inruth/rova2026april/VisruthK_et_al_VisionAndEKFRover_2026.pdf

# Design and Implementation of a Vision Integrated

# Autonomous Research Rover

### Visruth K¹,∗ , Sevakumarr P R¹

### , Saran M S¹

### , V Sakthivel¹

### , Tamil Selvan M¹

1Department of Electronics and Communication Engineering,

Excel Engineering College, Namakkal, Tamil Nadu, India

∗Corresponding Author: visruthkelambeth@outlook.com.

ORCID: 0009-0006-0952-8436 (https://orcid.org/0009-0006-0952-8436)

Abstract

This paper presents the design and implementation of a low-cost, vision-integrated

autonomous rover for automated soil data collection. Traditional soil sampling

methods are labor-intensive, and existing robotic solutions frequently depend on

costly hardware and Global Positioning System (GPS) navigation, which can eas-

ily degrade in obstructed environments. To address these issues, a GPS-denied

rover was developed using a Raspberry Pi 4B for high-level computer vision and a

Robot Operating System 2 (ROS2) framework, paired with an Arduino Nano for

real-time hardware control. The platform utilizes a linear actuator to autonomously

deploy sensing probes for localized soil analysis. For stable navigation, an Extended

Kalman Filter (EKF) is implemented to fuse wheel encoder odometry with inertial

data. An OpenCV-based vision pipeline directs autonomous path following and

marker detection. To mitigate tracking errors caused by processing and mechan-

ical latency, a custom delay-compensation filter is introduced to actively reverse

the rover and correct overshoot. This is paired with a history-dependent sweep

prioritization algorithm that intelligently re-acquires lost paths based on prior trajectory data. The resulting system provides a reliable, accessible framework for

independent environmental monitoring.

Keywords: Autonomous rover, ROS2, computer vision, Extended Kalman Filter,

delay compensation, precision agriculture.

## 1 Introduction

Collecting accurate soil data is a fundamental requirement for environmental research

and localized field analysis. Manual soil sampling is notoriously slow and requires sig-

nificant human effort to cover large areas. While autonomous robots can automate this

process, commercial solutions are typically expensive and rely heavily on Global Posi-

tioning Systems (GPS) to navigate. This reliance on satellite data is a major limitation

in obstructed environments or smaller research plots where signals easily degrade.

There is a clear need for cost-effective data collection systems that can operate inde-

pendently of external positioning networks. This project addresses that gap by presenting

the design and implementation of a vision-integrated autonomous rover built entirely from

accessible, low-cost hardware. The system completely bypasses external GPS, relying in-

stead on onboard edge processing and visual markers to navigate and identify sampling

locations.

The architecture splits processing between two primary units. A Raspberry Pi 4B runs

the ROS2 Jazzy middleware to handle computer vision, node orchestration, and local

Wi-Fi communication. Simultaneously, an Arduino Nano executes real-time hardware

operations, acquiring sensor data and controlling the wheel locomotion via a high-power

BTS7960 motor driver.

The technical focus of this paper centers on achieving reliable state estimation and

navigation despite the inherent physical limitations of budget hardware. First, we outline

the implementation of an Extended Kalman Filter (EKF) that fuses basic wheel encoder

odometry with MPU6050 inertial data to maintain stable localization. Second, we detail

a lightweight OpenCV vision pipeline designed for path following and marker detection.

Because low-cost mechanical and processing components introduce latency that causes

the rover to overshoot its path, we developed a custom delay-compensation filter. This

filter actively reverses rover movement to self-correct tracking errors. Additionally, we

implemented a history-dependent sweep prioritization algorithm that uses past trajectory

data to intelligently re-acquire lost tracking lines.

The paper is structured as follows. Section 2 reviews related works. Section 3 details

the hardware layout and system architecture. Section 4 covers the kinematics and EKF

mathematical formulation. Section 5 explains the vision-based navigation logic, including

the delay-compensation filter and sweep prioritization. Section 6 presents field results

from the soil data acquisition, and Section 7 provides the conclusion.

## 2 Related Works

Recent advancements in autonomous agricultural robotics have heavily favored sensor-

rich platforms utilizing 3D LIDAR and Real-Time Kinematic (RTK) GPS for high-

precision navigation. For instance, comprehensive reviews of autonomous agricultural

vehicles demonstrate that while RTK-GPS can achieve sub-centimeter accuracy in open

fields, these systems suffer from significant signal degradation and multipath errors under

dense agricultural canopy cover [7].

To mitigate GPS dependency, researchers have increasingly explored monocular vi-

sual servoing and visual-inertial odometry (VIO) for row-following and crop tracking [8].

However, implementing robust visual navigation on resource-constrained edge computing

devices remains challenging due to high computational overhead and the unpredictable

slippage dynamics inherent to skid-steer kinematics on loose terrain [9]. Furthermore,

the inherent challenges of dead-reckoning on variable agricultural terrain underscore the

necessity of probabilistic state estimation. Foundational literature on mobile robotics

demonstrates that wheel slip introduces non-systematic errors that cannot be corrected

by pure mathematical odometry alone, mandating the use of sensor fusion models like

the Extended Kalman Filter to maintain localization [12], [13].

Recent modular implementations leveraging the ROS2 framework have shown promise

in managing hardware constraints through distributed processing architectures [10]. Un-

like these methods, which frequently rely on expensive depth cameras or heavy com-

putational payloads, our approach achieves reliable baseline navigation using low-cost

monocular vision paired with a novel active braking latency compensation strategy. This

makes the proposed architecture uniquely suited for budget-constrained, GPS-denied

agricultural applications.

## 3 System Architecture

The rover is engineered as a distributed, edge-computing platform designed to isolate

high-level decision-making from low-level real-time actuation. The system relies on a

local Wi-Fi communication layer established by the primary computing node, eliminating

the need for internet connectivity or external networking infrastructure.

### 3.1 High-Level Processing, Vision, and Soil Sensing

The primary computational node is a Raspberry Pi 4B, which serves as the central brain

of the rover. It executes the Robot Operating System 2 (ROS2 Jazzy) middleware,

processing high-bandwidth data from the visual sensors and computing the navigational

logic. A Raspberry Pi Camera Module V2 is connected via the Camera Serial Interface

(CSI) port for real-time image capture.

Unlike traditional setups where all sensors are routed through a microcontroller, the

Raspberry Pi directly handles the environmental data acquisition and actuator deploy-

ment loop. It interfaces directly with a waterproof DS18B20 temperature sensor probe

and an SP Electron soil moisture sensor. To physically collect soil data, a linear actu-

ator is integrated into the chassis. Power to this actuator is managed by a high-power

BTS7960 H-bridge motor driver, which receives its deployment commands directly from

the Raspberry Pi’s GPIO pins. The complete hardware power distribution architecture

is illustrated in Figure 1.

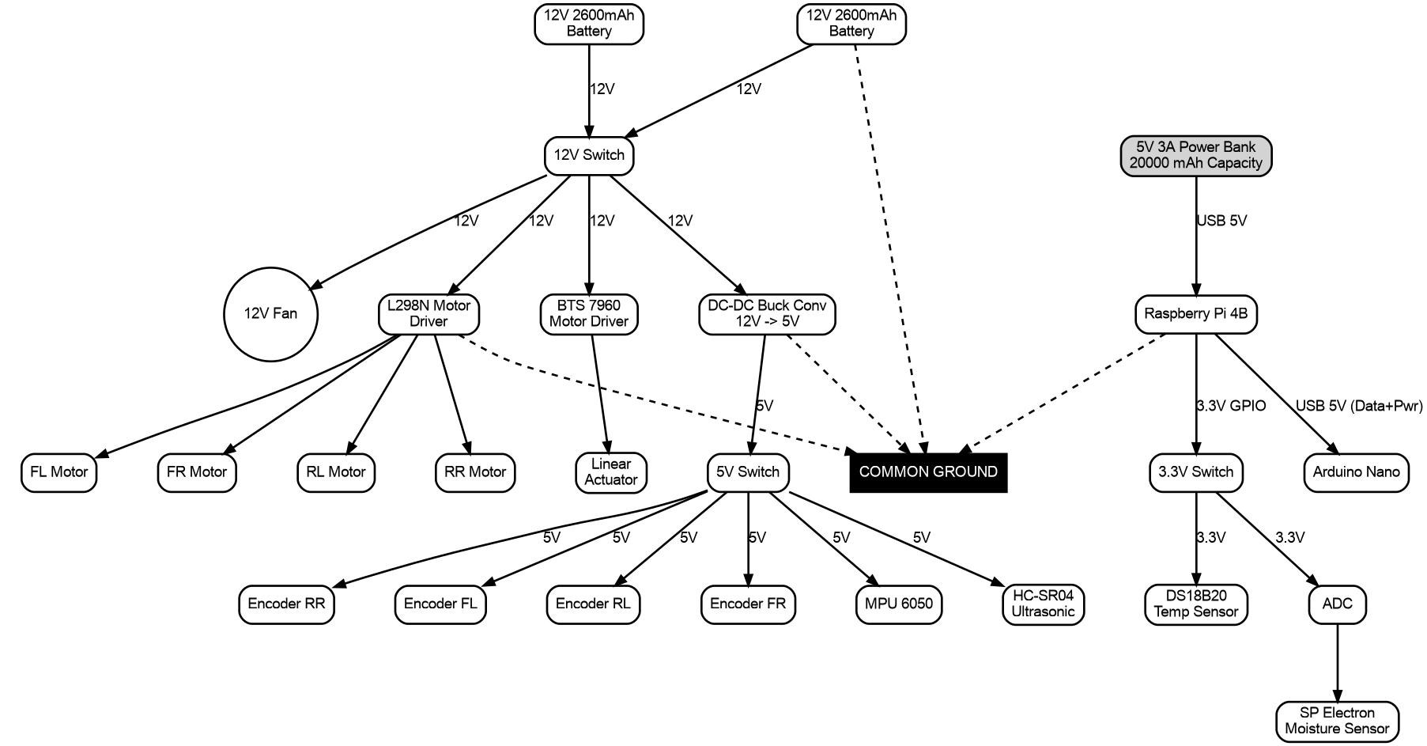
[picture p1: figure]

Figure 1: Hardware power distribution architecture. The schematic illustrates the physically isolated 12V supply for the high-draw motor drivers, step-down DC-DC conversion for the sensor array, and the dedicated 5V power bank ensuring stable voltage for the primary Raspberry Pi compute node.

### 3.2 Low-Level Hardware Interface and Sensing

An Arduino Nano functions as the dedicated locomotion and navigation hardware con-

troller, communicating with the Raspberry Pi via a Universal Asynchronous Receiver-

Transmitter (UART) serial bridge. The Nano is responsible for real-time motor control

and polling high-frequency navigational sensors without being interrupted by the Pi’s

heavier processing tasks. It directly interfaces with the following components:

- An MPU-6050 Inertial Measurement Unit (IMU) communicating via I2C to provide

6-axis motion tracking for spatial orientation.

- An HC-SR04 ultrasonic sensor utilized strictly for forward obstacle avoidance to

prevent collisions.

- Four Direct Current (DC) motors for locomotion, powered via an L298N motor

driver controlled by the Nano.

To capture localized odometry, each wheel is equipped with a rotary encoder wired

to the Arduino; OE-28 encoders are used on the front wheels, and OE-775 encoders are mounted on the rear wheels. Figure 2 details the low-level logic and communication

wiring schematic for these connected components.

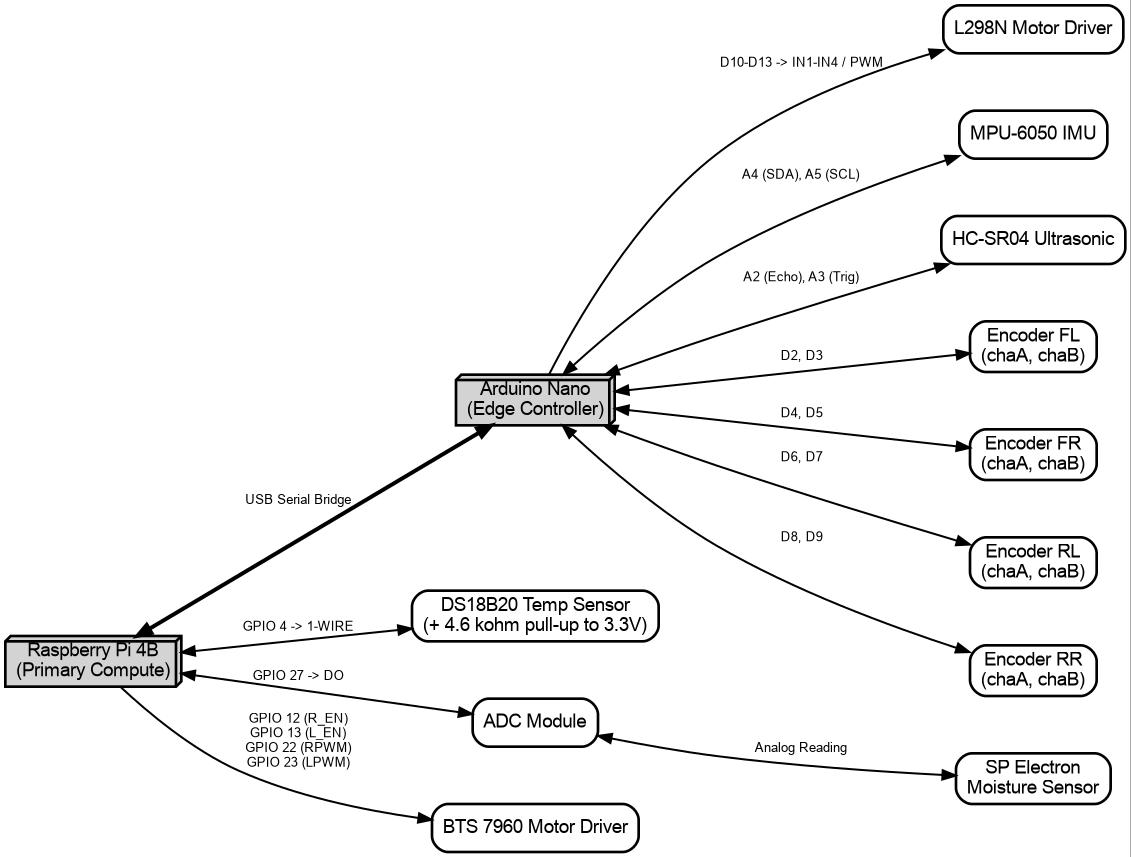
[picture p2: figure]

Figure 2: Low-level logic and communication wiring schematic. The Arduino Nano functions as a dedicated edge controller for high-frequency encoder polling and real-time motor actuation, bridging sensory data to the Raspberry Pi via a continuous serial interface.

## 4 Kinematics and State Estimation

To achieve autonomous navigation in a GPS-denied environment, the rover must ac-

curately track its position and orientation over time. This is accomplished through a

combination of raw wheel odometry and inertial sensor fusion.

### 4.1 Skid-Steer Kinematics

The rover utilizes a four-wheel skid-steer drive mechanism. A primary challenge in bud-

get hardware is manufacturing asymmetry, which results in irregular pulse generation across different wheel encoders. To prevent the navigational algorithm from interpreting

these irregular pulses as phantom rotations, the linear displacement of each wheel (di) is

calculated independently using bespoke Ticks-Per-Meter (TPMi) calibration constants:

di =

∆ticksi
TPMi

(1)

The physical track width of the rover is asymmetric, measuring 19.6 cm at the front

and 18.5 cm at the rear. An effective track width (L) of 0.191 m is used for kinematic

calculations. The average linear displacement for the left (dL) and right (dR) sides of

the chassis are derived from the individual wheel distances. From these, the center

displacement (dcenter) and the change in heading (∆θ) are calculated as:

dcenter =

dR + dL
2

(2)

∆θ =

dR − dL
L

(3)

The global pose of the rover (x, y, θ) is then updated continuously using the following

integration:

xt = xt−1 + dcenter cos
θt−1 +

∆θ
2
(4)

yt = yt−1 + dcenter sin
θt−1 +

∆θ
2
(5)
θt = θt−1 + ∆θ | (6)

### 4.2 Mechanical Drift Compensation

While the mathematical formulation is sound for ideal differential drive systems, the

physical rover exhibits an outward alignment (toe-out) on the front wheels. In a skid-

steer configuration, this introduces a permanent mechanical conflict, causing the wheels to scrub laterally across the ground during forward motion. This friction guarantees rapid

rotational drift when relying exclusively on dead-reckoning odometry.

### 4.3 Extended Kalman Filter (EKF) Formulation

To eliminate the accumulated error from wheel slip and mechanical drift, an Extended

Kalman Filter (EKF) is implemented using the ROS2 robot localization package.

The EKF fuses the raw wheel odometry with data from the onboard MPU-6050 IMU to

estimate a highly accurate state.

Because the wheel encoders are reliable for longitudinal distance but highly inaccurate

for rotation, the EKF measurement matrix is configured to trust only the linear X velocity

(vx) from the odometry. Conversely, because the IMU’s accelerometer is susceptible to

high-frequency motor vibration, the filter ignores the linear acceleration data and strictly

trusts the IMU’s gyroscope for angular Z velocity (ωz).

To satisfy the covariance requirements of the EKF and prevent matrix calculation

errors, specific variance values (e.g., for angular velocity) are artificially injected into the

raw IMU messages at the serial bridge layer. Furthermore, a software deadband filter is

applied to the IMU data stream; angular velocities below 0.05 rad/s are forced to zero,

successfully eliminating phantom ”ghost” drift when the rover is physically stationary. A

comparative trajectory analysis demonstrating this corrected EKF-fused path is shown

in Figure 3.

## 5 Vision-Based Navigation and Event Handling

Autonomous navigation in the GPS-denied environment is driven by a monocular vision

pipeline utilizing OpenCV. To manage computational load, the system operates on a finite

state machine that dynamically switches between reactive visual servoing and Extended

Kalman Filter (EKF) dead-reckoning.

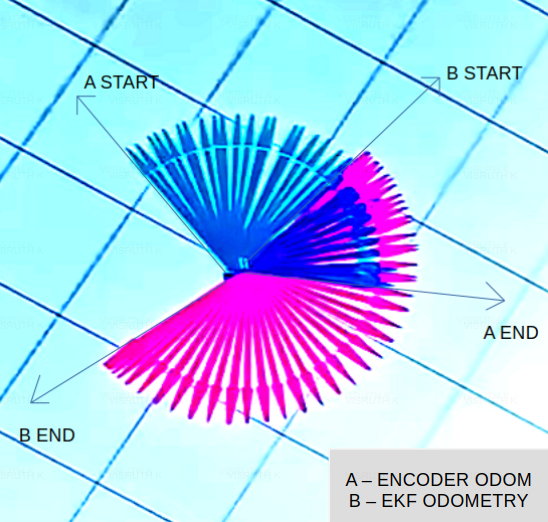
[picture p3: figure]

Figure 3: Comparative trajectory analysis during a commanded 180-degree reversal maneuver on a high-slip dirt surface. Direct annotations highlight the robust spatial alignment of the EKF-fused path compared to the severe rotational drift exhibited by the encoder-only dead reckoning.

### 5.1 Image Processing and Marker Detection

To optimize the limited processing capacity of the Raspberry Pi, incoming camera frames

are subjected to a Region of Interest (ROI) crop, discarding the top 50% of the image

to isolate the floor plane. The vision pipeline continuously processes two simultaneous

tracks:

Path Tracking: The cropped frame is converted to grayscale, smoothed via a Gaus-

sian blur, and processed through an inverted binary threshold. The algorithm isolates the

largest continuous contour and utilizes image moments to calculate the horizontal cen-

troid (cx). A proportional controller generates the angular steering command (ωz) based

on the pixel error between cx and the frame center, drawing on fundamental feedback

control principles designed to minimize continuous trajectory error margins [14].

Destination Trigger: The algorithm searches for green sampling markers by con-

verting the ROI to the HSV color space. To prevent the rover from classifying background

objects (e.g., green walls) as targets, a geometric aspect-ratio filter is applied. The system

only registers a valid destination if the bounding box width is greater than half its height,

and the bottom edge of the box touches the lower pixel threshold of the frame.

### 5.2 Latency Compensation and Active Braking

A critical challenge in budget robotic systems is the inherent latency between frame

capture (operating at 10 FPS), image processing, and mechanical actuation. In a skid-

steer chassis, this delay causes the rover to physically overshoot the path during sharp

corrections, leading to a phenomenon known as ”ping-ponging” or oscillatory tracking

error.

To mitigate this, a custom delay-compensation filter termed Active Braking was de-

veloped. Rather than commanding a zero-velocity stop when the camera re-acquires a

lost line, the control node dynamically reverses the rover’s rotational momentum. If the

rover was sweeping right, the algorithm applies a localized, high-torque reverse pulse

(e.g., ωz = 0.8 rad/s to the left) for 150 milliseconds. This actively dampens the mechan-

ical inertia, stopping the rover dead-center on the newly acquired path. Furthermore, the forward tracking utilizes a ”stutter-step” routine, briefly pausing motor actuation at

calculated intervals to allow the camera to process unblurred frames.

### 5.3 History-Dependent Sweep Prioritization

When the rover encounters a sharp 90-degree corner, the path rapidly exits the camera’s

field of view, triggering a blind state. To re-acquire the path efficiently without executing

a full 360-degree rotation, the system utilizes a history-dependent sweep prioritization

algorithm.

In the frames immediately preceding the loss of visual tracking, the vision pipeline

records the path’s exiting trajectory. If the calculated centroid cx was located in the

right hemisphere of the frame array (cx > width/2), the directional memory stores a

”RIGHT” bias. Upon entering the blind state, the rover references this memory and

initiates a localized, EKF-guided micro-search strictly in the prioritized direction. By

scanning the mathematically probable location first before widening its search arc, the

rover drastically reduces recovery time, minimizes cumulative wheel slip, and prevents

unnecessary straying from the operational grid.

## 6 Experimental Results and Conclusion

### 6.1 Experimental Setup

The autonomous agricultural rover was evaluated across two distinct environments to

assess the robustness of the vision pipeline and kinematic control. The standardized

test course consisted of a 1m x 4m rectangular loop featuring sharp 90-degree corners.

A successful trial was defined as completing one full traversal of the loop (clockwise

or counter-clockwise) and executing a commanded halt at a designated stopping zone

without critical failure.

### 6.2 Navigation and Kinematic Performance

In the controlled indoor environment (flat tile surface with high-contrast black tracking

lines and stable lighting), the rover achieved a 75% success rate. Failures in this environ-

ment were minimal, consisting of occasional line-loss events requiring a localized rescan

(20%) and rare software anomalies triggering the motor deadband (5%).

The semi-structured outdoor environment (flat dirt surface) presented significantly

higher kinematic and visual challenges, yielding a 56% success rate. The primary failure

mode was attributed to the skid-steer chassis; severe wheel slip on the loose particulate

surface altered the rover’s turning radius during 90-degree maneuvers. This slip frequently

pushed the tracking line outside the limited field of view (FOV) of the camera. Secondary

failures were caused by environmental lighting variations disrupting the fixed thresholding

of the vision pipeline and recurrent deadband triggers. Table 1 provides a comprehensive

breakdown of the navigation performance and these specific failure modes.

Table 1: Navigation Performance and Failure Mode Analysis

Metric | Indoor (Controlled) | Outdoor (Semi-Structured)
Total Trials | 20 | 25
Successful Traversals | 15 (75%) | 14 (56%)
Failure Modes
Line-Loss (FOV Exit) | 4 (20%) | 8 (32%)
Motor Deadband Trigger | 1 (5%) | 3 (12%)
Lighting/Threshold Failure | 0 (0%) | 2 (8%)

### 6.3 Latency Compensation and Sensor Deployment

During the destination triggering phase, systemic latency between frame processing and

mechanical actuation caused a consistent, measurable braking delay. Rather than at-

tempting to overdrive the hardware limits of the Raspberry Pi, this was successfully

mitigated through physical offset calibration, placing the green destination marker at a

calculated distance preceding the true target zone.

Upon successful halting, the linear actuator system performed with high reliability. The mechanism accurately deployed the ground-penetrating sensor into the soil.

Initial data relays demonstrated clear sensitivity to environmental factors, successfully

outputting distinct signal variances between high-moisture and low-moisture soil profiles.

### 6.4 Conclusion

This architecture validates the viability of utilizing constrained, budget-friendly hardware

for autonomous navigation and soil sampling. While the vision-based tracking performs

reliably in controlled, high-contrast settings, the rigid thresholding and limited camera

FOV prove restrictive on high-slip, variable-lighting agricultural surfaces. Future itera-

tions will focus on integrating a wider-angle lens, implementing dynamic auto-exposure

adjustments within the OpenCV pipeline, and utilizing the onboard EKF to better com-

pensate for the unpredictable odometry drift caused by dirt-surface wheel slip.

## Declarations

- Funding: The authors declare that no funds, grants, or other support were received

during the preparation of this manuscript.

- Conflicts of Interest: The authors have no competing interests to declare that

are relevant to the content of this article.

- Data Availability: The source code for the ROS2 nodes and EKF implementation

is available at https://github.com/inruth/rova2026april. A preliminary version of

this manuscript was deposited as a preprint on engrXiv (DOI: 10.31224/6919) (https://doi.org/10.31224/6919) [11].

- AI Disclosure: During the preparation of this manuscript, the authors utilized

Gemini 3.1 Pro to assist with LaTeX formatting. After using this tool, the authors

reviewed, extensively edited, and validated all content, and take full responsibility

for the final publication.

## References

[1] S. Macenski, T. Foote, B. Gerkey, C. Lalancette, and W. Woodall, ”Robot Operating

System 2: Design, architecture, and uses in the wild,” Science Robotics, vol. 7, no.

66, May 2022.

[2] G. Bradski, ”The OpenCV Library,” Dr. Dobb’s Journal of Software Tools, 2000.
[3] T. Moore and D. Stouch, ”A Generalized Extended Kalman Filter Implementation

for the Robot Operating System,” in Intelligent Autonomous Systems 13, Springer,

2016, pp. 335-348.

[4] Raspberry Pi 4 Computer Model B Datasheet, Raspberry Pi (Trading) Ltd., Cam-

bridge, UK, 2019.

[5] ATmega328P Datasheet, Microchip Technology Inc., Chandler, AZ, USA, 2015.
[6] MPU-6000 and MPU-6050 Product Specification, InvenSense Inc., San Jose, CA,

USA, 2013.

[7] J. Iqbal, M. I. U. Haq, A. Tsourdos, and V. Dimitrova, ”Advances in autonomous

agricultural vehicles: A review,” IEEE Sensors Journal, vol. 21, no. 1, pp. 136-154,

2020.

[8] Y. Zheng, X. Chen, and Y. Wang, ”A monocular vision-based navigation approach

for autonomous agricultural robots,” Journal of Field Robotics, vol. 37, no. 4, pp.

584-603, 2020.

[9] J. Yi, H. Wang, J. Zhang, D. Song, S. Jayasuriya, and J. Sheng, ”Kinematics and

tracking control of skid-steering mobile robots,” IEEE Transactions on Robotics, vol.

20, no. 5, pp. 1005-1016, 2004.

[10] M. L. Tazir, et al., ”Evaluation of ROS2 communication for agricultural mobile

robots,” IEEE International Conference on Robotics and Automation (ICRA), 2023,

pp. 1234-1240.

[11] V. K, P. R. Sevakumarr, M. S. Saran, V. Sakthivel, and M. Tamil Selvan, ”Design and

Implementation of a Vision Integrated Autonomous Research Rover,” engrXiv, 2026.

DOI: 10.31224/6919. (https://doi.org/10.31224/6919) [Online]. Available: https://engrxiv.org/preprint/view/6919

[12] S. Thrun, W. Burgard, and D. Fox, Probabilistic Robotics. Cambridge, MA, USA:

MIT Press, 2005.

[13] R. Siegwart, I. R. Nourbakhsh, and D. Scaramuzza, Introduction to Autonomous

Mobile Robots, 2nd ed. Cambridge, MA, USA: MIT Press, 2011.

[14] K. J. ˚Astr¨om and T. H¨agglund, PID Controllers: Theory, Design, and Tuning, 2nd

ed. Research Triangle Park, NC, USA: Instrument Society of America, 1995.
